markcaudill/mwc6502/BusMonitor.sch

## KiCad design BusMonitor.sch (2021-03-17)

Schematic: BusMonitor.sch

Parts:
A1: Arduino_Nano_v3.x; Arduino_Nano
R3, R4: 4.7k; R_Axial_DIN0207_L6.3mm_D2.5mm_P7.62mm_Horizontal
U8, U9: MCP23017_SP; DIP-28_W7.62mm
U10: LCD_I2C_Generic; PinHeader_1x04_P2.54mm_Vertical
