markcaudill/mwc6502/MWC 6502 v1.0.sch

## KiCad design MWC 6502 v1.0.sch (2021-03-17)

Schematic: MWC 6502 v1.0.sch

Parts:
C1: .22uF; CP_Radial_D5.0mm_P2.50mm
C2, C5: .01uF; C_Disc_D7.5mm_W5.0mm_P7.50mm
C3: .1uF; CP_Radial_D5.0mm_P2.50mm
C4, C7, C8, C9: .1uF; C_Disc_D4.3mm_W1.9mm_P5.00mm
C6: 10uF; CP_Radial_D5.0mm_P2.50mm
R1, R2: 10k; R_Axial_DIN0207_L6.3mm_D2.5mm_P7.62mm_Horizontal
SW1: PWR_RES; SW_PUSH_6mm
U1: 74HC00; DIP-16_W7.62mm_Socket
U2: 65C02S; DIP-40_W15.24mm_Socket
U3: DS1233; TO-92_Inline_Wide
U4: 62256; DIP-28_W15.24mm_Socket
U5: LM7805_TO220; TO-220-3_Vertical
U6: 28C256; DIP_Socket-28_W11.9_W12.7_W15.24_W17.78_W18.5_3M_228-1277-0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
U7: LM555xN; DIP-8_W7.62mm

Notes on the sheet:
0.678Hz Clock
Microprocessor
RAM
ROM
Address Decoding
Power Reset
Voltage Regulator
Place .1uF capacitors near VCC of each IC
