markcaudill/mwc6502/(commit log)

2021-03-16 Initial commit.
    [BusMonitor.sch, MWC 6502 v1.0.kicad_pcb, MWC 6502 v1.0.sch, W65C02S OpCode Matrix.ods]
2021-03-16 Tie IO expander resets to Arduino reset.
    [BusMonitor.sch]
2021-03-16 Add sync connection.
    [BusMonitor.sch]
2021-03-17 Remove PCB for now. Not accurate anyway.
    [MWC 6502 v1.0.kicad_pcb]
2021-03-17 Add footprints to schematic.
    [BusMonitor.sch, MWC 6502 v1.0.sch]
2021-03-17 Switch to serial. Add mnemonics.
2021-03-18 Switch to underscores in attempt to appease GitHub gods.
